CogniPilot/spinali_mcxn_t1_shields/kicad/spinali_mcxn_t1_oflo/spinali_mcxn_t1_oflo.kicad_pcb

## KiCad design kicad/spinali_mcxn_t1_oflo/spinali_mcxn_t1_oflo.kicad_pcb (2026-08-24)

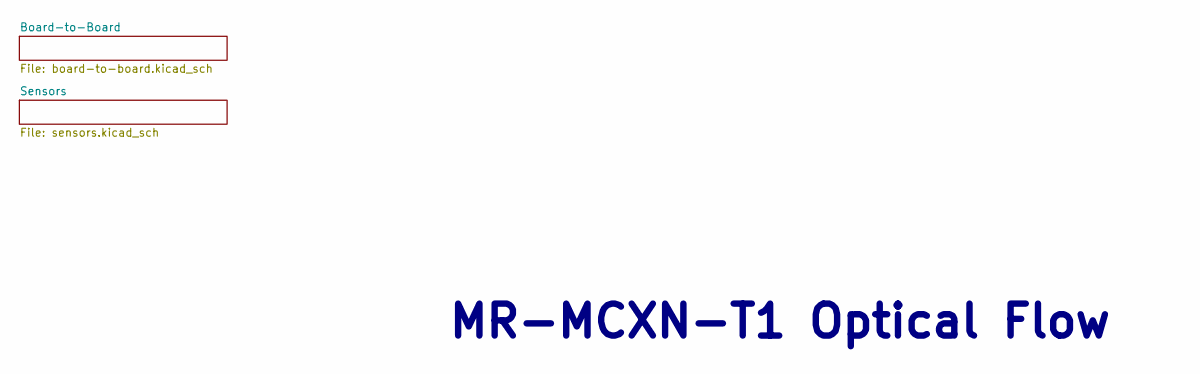
[picture p1: schematic spinali_mcxn_t1_oflo.kicad_sch, ${TITLE}]

Notes on the sheet:
MR-MCXN-T1 Optical Flow

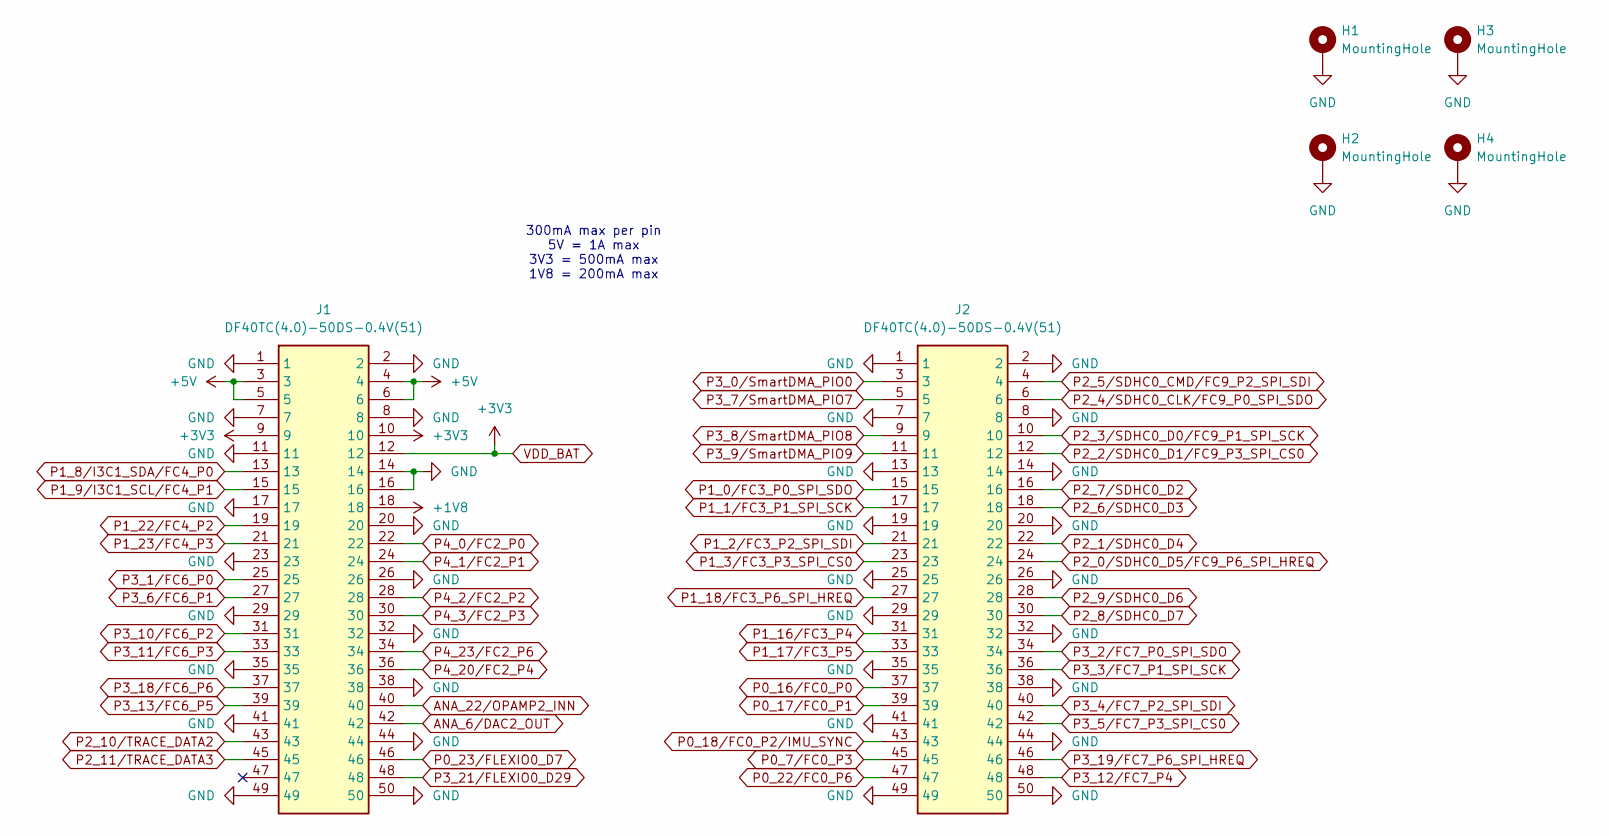
[picture p2: schematic board-to-board.kicad_sch, ${TITLE}]

Parts:
H1, H2, H3, H4: MountingHole; MountingHole_3.2mm_M3_DIN965_Pad
J1, J2: DF40TC(4.0)-50DS-0.4V(51); DigiKey 26-DF40TC(4.0)-50DS-0.4V(51)CT-ND

Connections:
+1V8: J1.18; also elsewhere on the board
+5V: J1.3, J1.4, J1.5, J1.6; also elsewhere on the board
ANA_6/DAC2_OUT: J1.42
ANA_22/OPAMP2_INN: J1.40
GND: H1.1, H2.1, H3.1, H4.1, J1.1, J1.2, J1.7, J1.8, J1.11, J1.14, J1.16, J1.17, J1.20, J1.23, J1.26, J1.29, J1.32, J1.35, J1.38, J1.41, J1.44, J1.49, J1.50, J2.1, J2.2, J2.7, J2.8, J2.13, J2.14, J2.19, J2.20, J2.25, J2.26, J2.29, J2.32, J2.35, J2.38, J2.41, J2.44, J2.49, J2.50; also elsewhere on the board
P0_7/FC0_P3: J2.45
P0_16/FC0_P0: J2.37
P0_17/FC0_P1: J2.39
P0_18/FC0_P2/IMU_SYNC: J2.43; also elsewhere on the board
P0_22/FC0_P6: J2.47
P0_23/FLEXIO0_D7: J1.46
P1_0/FC3_P0_SPI_SDO: J2.15; also elsewhere on the board
P1_1/FC3_P1_SPI_SCK: J2.17; also elsewhere on the board
P1_2/FC3_P2_SPI_SDI: J2.21; also elsewhere on the board
P1_3/FC3_P3_SPI_CS0: J2.23; also elsewhere on the board
P1_8/I3C1_SDA/FC4_P0: J1.13
P1_9/I3C1_SCL/FC4_P1: J1.15
P1_16/FC3_P4: J2.31
P1_17/FC3_P5: J2.33
P1_18/FC3_P6_SPI_HREQ: J2.27; also elsewhere on the board
P1_22/FC4_P2: J1.19
P1_23/FC4_P3: J1.21
P2_0/SDHC0_D5/FC9_P6_SPI_HREQ: J2.24; also elsewhere on the board
P2_1/SDHC0_D4: J2.22
P2_2/SDHC0_D1/FC9_P3_SPI_CS0: J2.12; also elsewhere on the board
P2_3/SDHC0_D0/FC9_P1_SPI_SCK: J2.10; also elsewhere on the board
P2_4/SDHC0_CLK/FC9_P0_SPI_SDO: J2.6; also elsewhere on the board
P2_5/SDHC0_CMD/FC9_P2_SPI_SDI: J2.4; also elsewhere on the board
P2_6/SDHC0_D3: J2.18
P2_7/SDHC0_D2: J2.16
P2_8/SDHC0_D7: J2.30
P2_9/SDHC0_D6: J2.28
P2_10/TRACE_DATA2: J1.43
P2_11/TRACE_DATA3: J1.45
P3_0/SmartDMA_PIO0: J2.3
P3_1/FC6_P0: J1.25; also elsewhere on the board
P3_2/FC7_P0_SPI_SDO: J2.34; also elsewhere on the board
P3_3/FC7_P1_SPI_SCK: J2.36; also elsewhere on the board
P3_4/FC7_P2_SPI_SDI: J2.40; also elsewhere on the board
P3_5/FC7_P3_SPI_CS0: J2.42; also elsewhere on the board
P3_6/FC6_P1: J1.27; also elsewhere on the board
P3_7/SmartDMA_PIO7: J2.5
P3_8/SmartDMA_PIO8: J2.9
P3_9/SmartDMA_PIO9: J2.11
P3_10/FC6_P2: J1.31; also elsewhere on the board
P3_11/FC6_P3: J1.33; also elsewhere on the board
P3_12/FC7_P4: J2.48
P3_13/FC6_P5: J1.39
P3_18/FC6_P6: J1.37; also elsewhere on the board
P3_19/FC7_P6_SPI_HREQ: J2.46; also elsewhere on the board
P3_21/FLEXIO0_D29: J1.48
P4_0/FC2_P0: J1.22
P4_1/FC2_P1: J1.24
P4_2/FC2_P2: J1.28
P4_3/FC2_P3: J1.30
P4_20/FC2_P4: J1.36
P4_23/FC2_P6: J1.34
VDD_BAT: J1.9, J1.10, J1.12; also elsewhere on the board

Notes on the sheet:
300mA max per pin 5V = 1A max 3V3 = 500mA max 1V8 = 200mA max

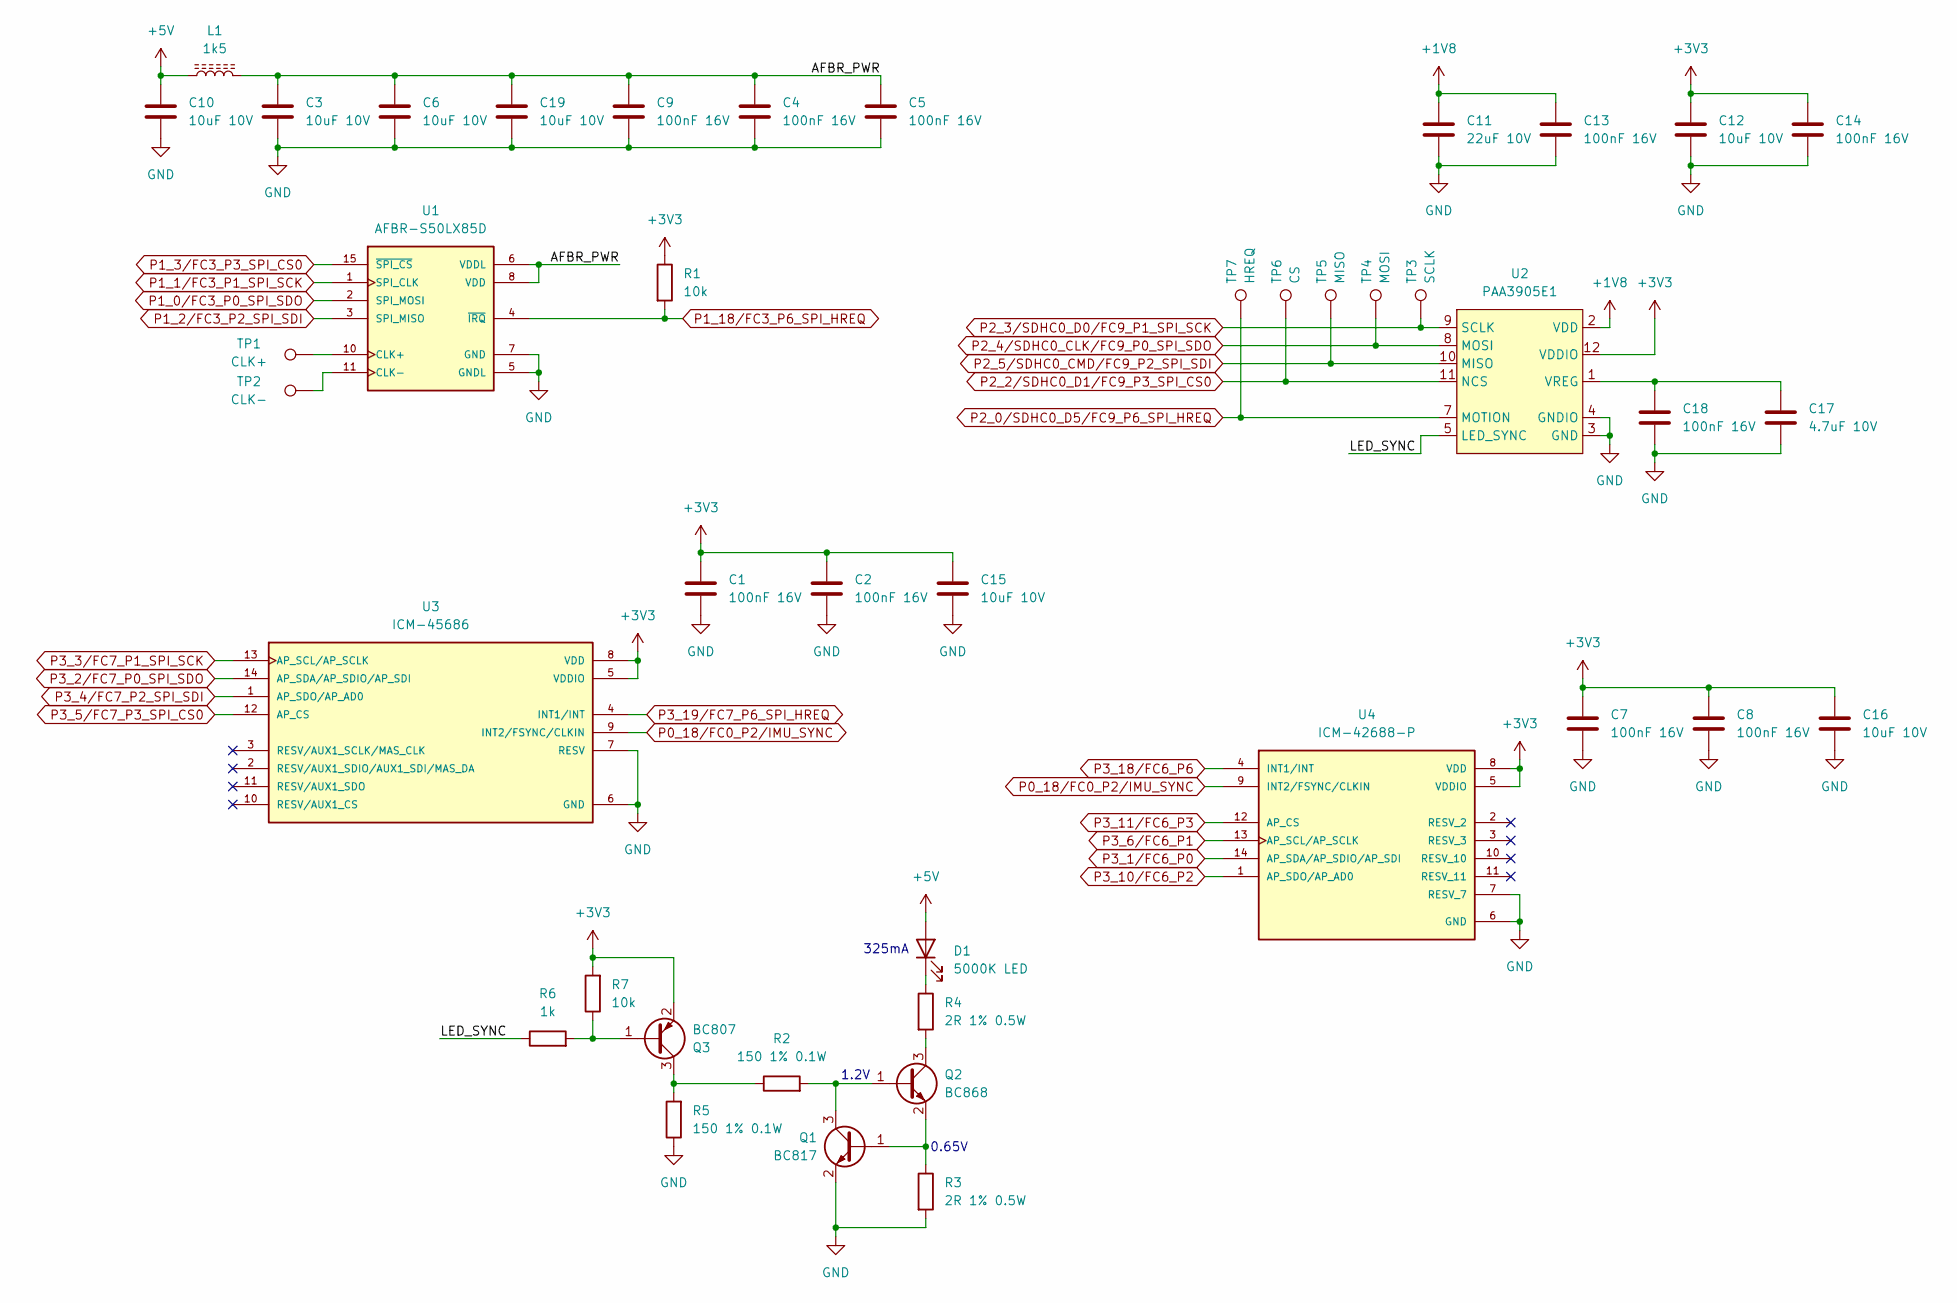
[picture p3: schematic sensors.kicad_sch, ${TITLE}]

Parts:
C1, C2, C4, C5, C7, C8, C9, C13, C14, C18: 100nF 16V; C_0402_1005Metric; JLCPCB C1525
C3, C6, C10, C12, C15, C16, C19: 10uF 10V; C_0805_2012Metric; JLCPCB C86038
C11: 22uF 10V; C_1206_3216Metric; JLCPCB C91604
C17: 4.7uF 10V; C_0603_1608Metric; JLCPCB C389010
D1: 5000K LED; JK3030AWT-P-U50EA; DigiKey 2138-JK3030AWT-P-U50EA0000-N0000001CT-ND
L1: 1k5; L_0603_1608Metric; JLCPCB C82155
Q1: BC817; SOT-23; DigiKey 1727-2919-1-ND
Q2: BC868; SOT-89-3; DigiKey 1727-1568-1-ND
Q3: BC807; SOT-23; DigiKey 1727-2917-1-ND
R1: 10k; R_0402_1005Metric; JLCPCB C144807
R2, R5: 150 1% 0.1W; R_0603_1608Metric; DigiKey 13-AC0603FR-10150RLCT-ND
R3, R4: 2R 1% 0.5W; R_1210_3225Metric; DigiKey 13-RC1210FR-072RLCT-ND
R6: 1k; R_0603_1608Metric; DigiKey 13-AC0603FR-101KLCT-ND
R7: 10k; R_0603_1608Metric; DigiKey 13-AC0603FR-1310KLCT-ND
TP1: CLK+; SolderWirePad_1x01_SMD_1x2mm
TP2: CLK-; SolderWirePad_1x01_SMD_1x2mm
TP3: SCLK; TestPoint_Pad_D1.0mm
TP4: MOSI; TestPoint_Pad_D1.0mm
TP5: MISO; TestPoint_Pad_D1.0mm
TP6: CS; TestPoint_Pad_D1.0mm
TP7: HREQ; TestPoint_Pad_D1.0mm
U1: AFBR-S50LX85D; AFBR-S50xxxxx; DigiKey 516-AFBR-S50LX85D-ND
U2: PAA3905E1; PAA3905E1-Q
U3: ICM-45686; IC_ICM-45686; JLCPCB C22459454
U4: ICM-42688-P; IC_ICM-42688-P; JLCPCB C1850418

Connections:
+1V8: C11.1, C13.1, U2.2 (VDD); also elsewhere on the board
+5V: C10.1, D1.2 (A), L1.1; also elsewhere on the board
/Sensors/LED_SYNC: R6.1, U2.5 (LED_SYNC)
GND: C1.2, C2.2, C3.2, C4.2, C5.2, C6.2, C7.2, C8.2, C9.2, C10.2, C11.2, C12.2, C13.2, C14.2, C15.2, C16.2, C17.2, C18.2, C19.2, Q1.2 (E), R3.2, R5.1, U1.5 (GNDL), U1.7 (GND), U1.9 (GND), U1.14 (GND), U2.3 (GND), U2.4 (GNDIO), U3.6 (GND), U3.7 (RESV), U4.6 (GND), U4.7 (RESV_7); also elsewhere on the board
unnamed: D1.1 (K), R4.1
unnamed: Q1.1 (B), Q2.2 (E), R3.1
unnamed: Q1.3 (C), Q2.1 (B), R2.2
unnamed: Q2.3 (C), R4.2
unnamed: Q3.1 (B), R6.2, R7.1
unnamed: Q3.3 (C), R2.1, R5.2
unnamed: TP1.1, U1.10 (CLK+)
unnamed: TP2.1, U1.11 (CLK-)
unnamed: C17.1, C18.1, U2.1 (VREG)
P0_18/FC0_P2/IMU_SYNC: U3.9 (INT2/FSYNC/CLKIN), U4.9 (INT2/FSYNC/CLKIN); also elsewhere on the board
P1_0/FC3_P0_SPI_SDO: U1.2 (SPI_MOSI); also elsewhere on the board
P1_1/FC3_P1_SPI_SCK: U1.1 (SPI_CLK); also elsewhere on the board
P1_2/FC3_P2_SPI_SDI: U1.3 (SPI_MISO); also elsewhere on the board
P1_3/FC3_P3_SPI_CS0: U1.15 (~SPI_CS); also elsewhere on the board
P1_18/FC3_P6_SPI_HREQ: R1.2, U1.4 (~IRQ); also elsewhere on the board
P2_0/SDHC0_D5/FC9_P6_SPI_HREQ: TP7.1, U2.7 (MOTION); also elsewhere on the board
P2_2/SDHC0_D1/FC9_P3_SPI_CS0: TP6.1, U2.11 (NCS); also elsewhere on the board
P2_3/SDHC0_D0/FC9_P1_SPI_SCK: TP3.1, U2.9 (SCLK); also elsewhere on the board
P2_4/SDHC0_CLK/FC9_P0_SPI_SDO: TP4.1, U2.8 (MOSI); also elsewhere on the board
P2_5/SDHC0_CMD/FC9_P2_SPI_SDI: TP5.1, U2.10 (MISO); also elsewhere on the board
P3_1/FC6_P0: U4.14 (AP_SDA/AP_SDIO/AP_SDI); also elsewhere on the board
P3_2/FC7_P0_SPI_SDO: U3.14 (AP_SDA/AP_SDIO/AP_SDI); also elsewhere on the board
P3_3/FC7_P1_SPI_SCK: U3.13 (AP_SCL/AP_SCLK); also elsewhere on the board
P3_4/FC7_P2_SPI_SDI: U3.1 (AP_SDO/AP_AD0); also elsewhere on the board
P3_5/FC7_P3_SPI_CS0: U3.12 (AP_CS); also elsewhere on the board
P3_6/FC6_P1: U4.13 (AP_SCL/AP_SCLK); also elsewhere on the board
P3_10/FC6_P2: U4.1 (AP_SDO/AP_AD0); also elsewhere on the board
P3_11/FC6_P3: U4.12 (AP_CS); also elsewhere on the board
P3_18/FC6_P6: U4.4 (INT1/INT); also elsewhere on the board
P3_19/FC7_P6_SPI_HREQ: U3.4 (INT1/INT); also elsewhere on the board
VDD: C3.1, C4.1, C5.1, C6.1, C9.1, C19.1, L1.2, U1.6 (VDDL), U1.8 (VDD), U1.13 (VDD)
VDD_BAT: C1.1, C2.1, C7.1, C8.1, C12.1, C14.1, C15.1, C16.1, Q3.2 (E), R1.1, R7.2, U2.12 (VDDIO), U3.5 (VDDIO), U3.8 (VDD), U4.5 (VDDIO), U4.8 (VDD); also elsewhere on the board

Notes on the sheet:
325mA
0.65V
1.2V

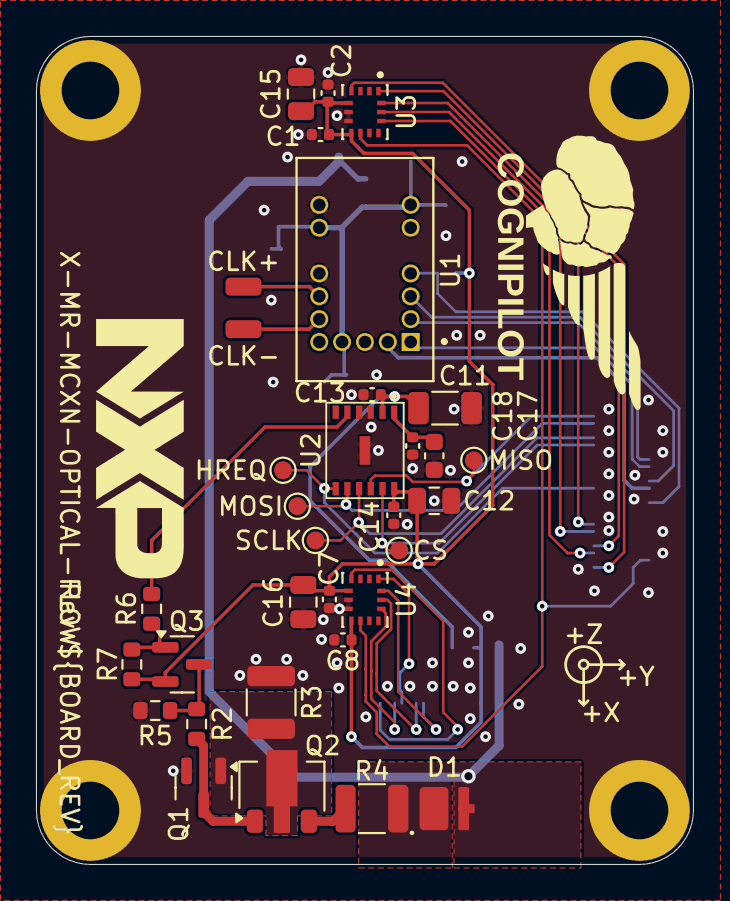
[picture p4: board spinali_mcxn_t1_oflo.kicad_pcb from above]

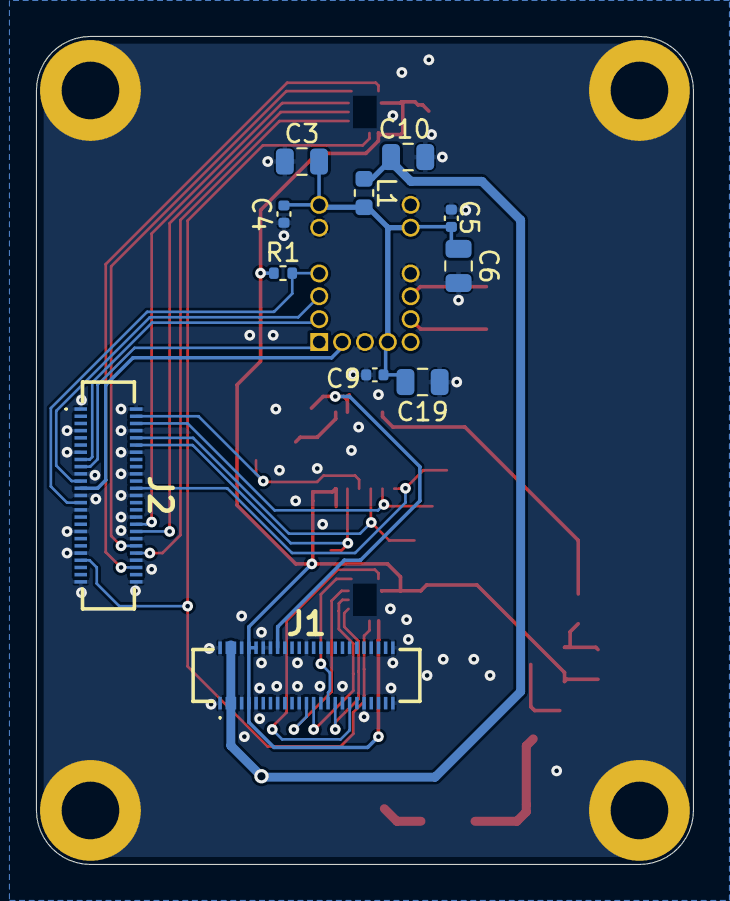
[picture p5: board spinali_mcxn_t1_oflo.kicad_pcb from below]

Board: 4 copper layers, 36.5 x 46.0 mm, 48 parts (11 on the bottom side), 36 nets.
