CogniPilot/spinali_mcxn_t1_shields/kicad/spinali_mcxn_t1_io/spinali_mcxn_t1_io.kicad_pcb

## KiCad design kicad/spinali_mcxn_t1_io/spinali_mcxn_t1_io.kicad_pcb (2026-08-24)

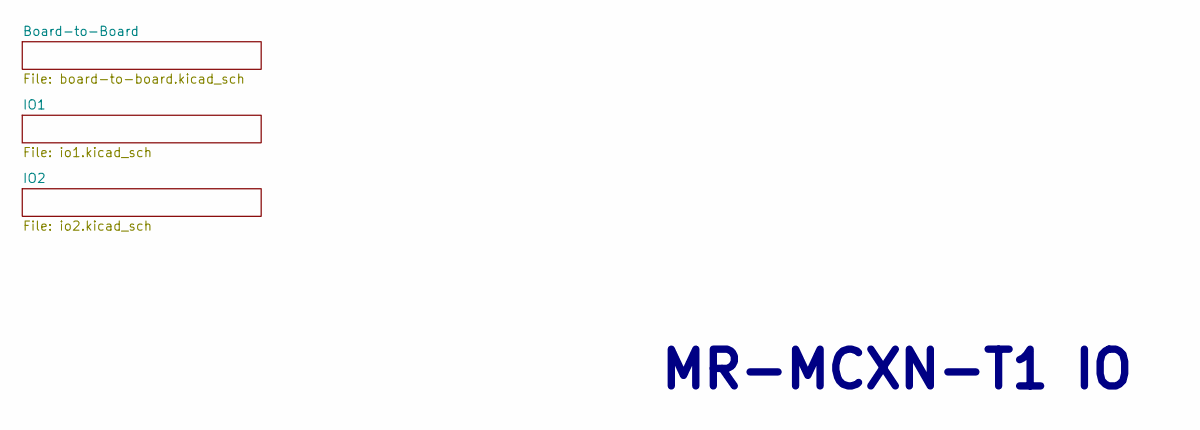
[picture p6: schematic spinali_mcxn_t1_io.kicad_sch, ${TITLE}]

Notes on the sheet:
MR-MCXN-T1 IO

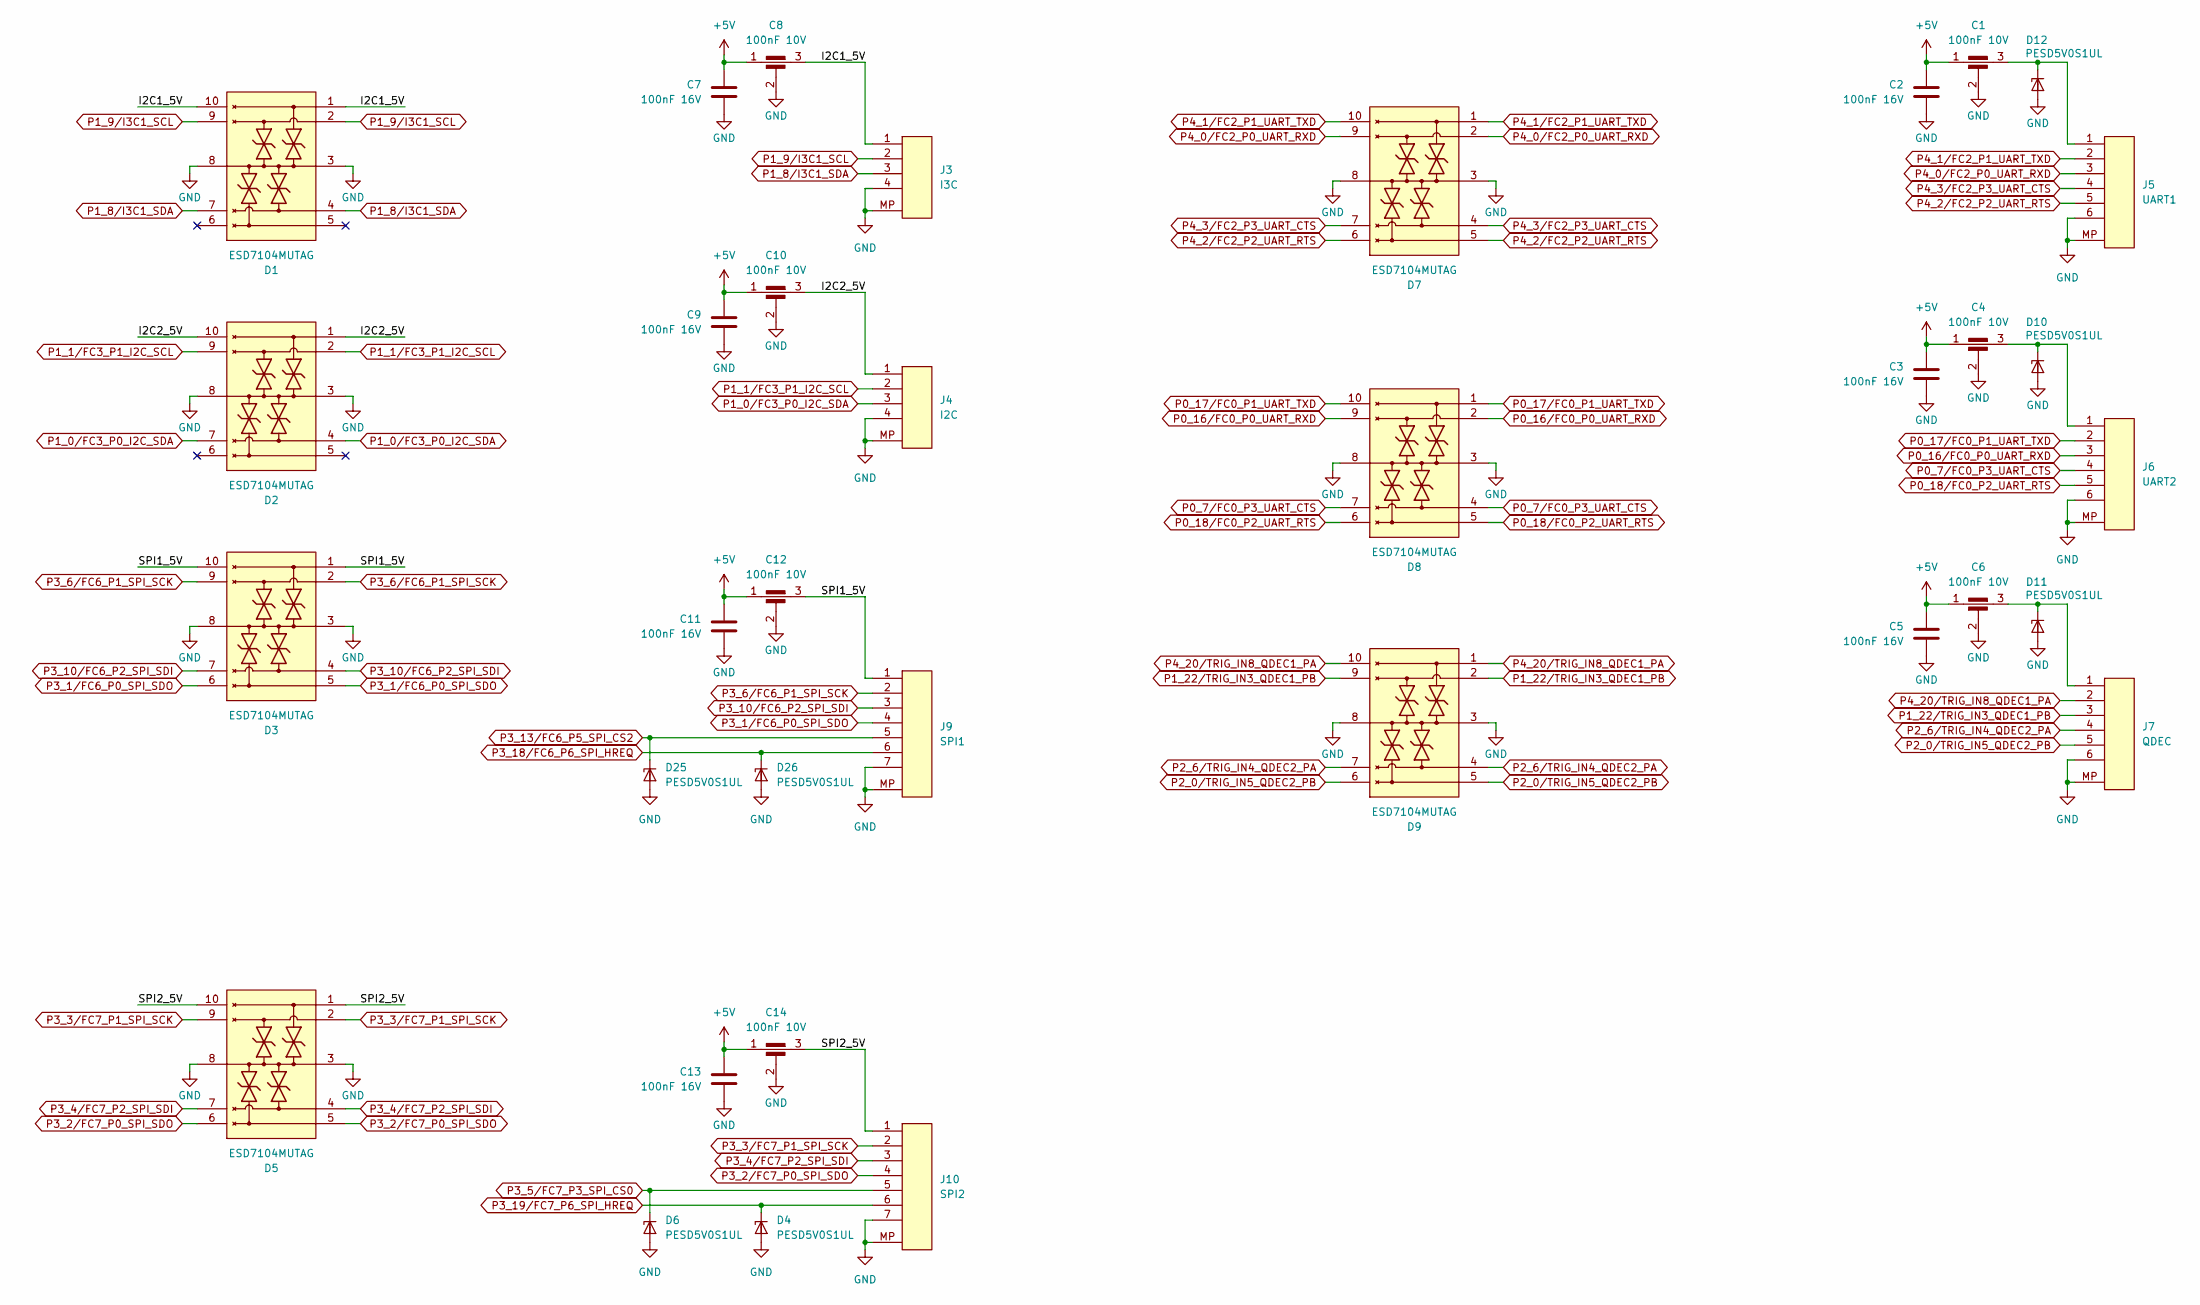
[picture p7: schematic io1.kicad_sch, ${TITLE}]

Parts:
C1, C4, C6, C8, C10, C12, C14: 100nF 10V; FIL_NFM15PC104R1A3D; DigiKey 490-17918-1-ND
C2, C3, C5, C7, C9, C11, C13: 100nF 16V; C_0402_1005Metric; DigiKey 490-6328-1-ND
D1, D2, D3, D5, D7, D8, D9: ESD7104MUTAG; ESD8104MUTAG; DigiKey ESD7104MUTAGOSCT-ND
D4, D6, D10, D11, D12, D25, D26: PESD5V0S1UL; PESD5V0S1ULD315; DigiKey 1727-4189-1-ND
J3: I3C; JST_GH_BM04B-GHS-TBT_1x04-1MP_P1.25mm_Vertical; DigiKey 455-BM04B-GHS-TBTCT-ND
J4: I2C; JST_GH_BM04B-GHS-TBT_1x04-1MP_P1.25mm_Vertical; DigiKey 455-BM04B-GHS-TBTCT-ND
J5: UART1; JST_GH_BM06B-GHS-TBT_1x06-1MP_P1.25mm_Vertical; DigiKey 455-BM06B-GHS-TBTCT-ND
J6: UART2; JST_GH_BM06B-GHS-TBT_1x06-1MP_P1.25mm_Vertical; DigiKey 455-BM06B-GHS-TBTCT-ND
J7: QDEC; JST_GH_BM06B-GHS-TBT_1x06-1MP_P1.25mm_Vertical; DigiKey 455-BM06B-GHS-TBTCT-ND
J9: SPI1; JST_GH_BM07B-GHS-TBT_1x07-1MP_P1.25mm_Vertical; DigiKey 455-BM07B-GHS-TBTCT-ND
J10: SPI2; JST_GH_BM07B-GHS-TBT_1x07-1MP_P1.25mm_Vertical; DigiKey 455-BM07B-GHS-TBTCT-ND

Connections:
+5V: C1.1, C2.1, C3.1, C4.1, C5.1, C6.1, C7.1, C8.1, C9.1, C10.1, C11.1, C12.1, C13.1, C14.1; also elsewhere on the board
/IO1/I2C1_5V: C8.3, D1.1 (IO_1), D1.10 (NC_4), J3.1
/IO1/I2C2_5V: C10.3, D2.1 (IO_1), D2.10 (NC_4), J4.1
/IO1/SPI1_5V: C12.3, D3.1 (IO_1), D3.10 (NC_4), J9.1
/IO1/SPI2_5V: C14.3, D5.1 (IO_1), D5.10 (NC_4), J10.1
GND: C1.2, C1.4 (2), C2.2, C3.2, C4.2, C4.4 (2), C5.2, C6.2, C6.4 (2), C7.2, C8.2, C8.4 (2), C9.2, C10.2, C10.4 (2), C11.2, C12.2, C12.4 (2), C13.2, C14.2, C14.4 (2), D1.3 (GND_1), D1.8 (GND_2), D2.3 (GND_1), D2.8 (GND_2), D3.3 (GND_1), D3.8 (GND_2), D4.2 (A), D5.3 (GND_1), D5.8 (GND_2), D6.2 (A), D7.3 (GND_1), D7.8 (GND_2), D8.3 (GND_1), D8.8 (GND_2), D9.3 (GND_1), D9.8 (GND_2), D10.2 (A), D11.2 (A), D12.2 (A), D25.2 (A), D26.2 (A), J3.4 (1), J3.MP, J4.4 (1), J4.MP, J5.6 (1), J5.MP, J6.6 (1), J6.MP, J7.6 (1), J7.MP, J9.7 (1), J9.MP, J10.7 (1), J10.MP; also elsewhere on the board
unnamed: C4.3, D10.1 (K1), J6.1
unnamed: C6.3, D11.1 (K1), J7.1
unnamed: C1.3, D12.1 (K1), J5.1
P0_7/FC0_P3_UART_CTS: D8.4 (IO_3), D8.7 (NC_2), J6.4 (1); also elsewhere on the board
P0_16/FC0_P0_UART_RXD: D8.2 (IO_2), D8.9 (NC_3), J6.3 (1); also elsewhere on the board
P0_17/FC0_P1_UART_TXD: D8.1 (IO_1), D8.10 (NC_4), J6.2 (1); also elsewhere on the board
P0_18/FC0_P2_UART_RTS: D8.5 (IO_4), D8.6 (NC_1), J6.5 (1); also elsewhere on the board
P1_0/FC3_P0_I2C_SDA: D2.4 (IO_3), D2.7 (NC_2), J4.3 (1); also elsewhere on the board
P1_1/FC3_P1_I2C_SCL: D2.2 (IO_2), D2.9 (NC_3), J4.2 (1); also elsewhere on the board
P1_8/I3C1_SDA: D1.4 (IO_3), D1.7 (NC_2), J3.3 (1); also elsewhere on the board
P1_9/I3C1_SCL: D1.2 (IO_2), D1.9 (NC_3), J3.2 (1); also elsewhere on the board
P1_22/TRIG_IN3_QDEC1_PB: D9.2 (IO_2), D9.9 (NC_3), J7.3 (1); also elsewhere on the board
P2_0/TRIG_IN5_QDEC2_PB: D9.5 (IO_4), D9.6 (NC_1), J7.5 (1); also elsewhere on the board
P2_6/TRIG_IN4_QDEC2_PA: D9.4 (IO_3), D9.7 (NC_2), J7.4 (1); also elsewhere on the board
P3_1/FC6_P0_SPI_SDO: D3.5 (IO_4), D3.6 (NC_1), J9.4 (1); also elsewhere on the board
P3_2/FC7_P0_SPI_SDO: D5.5 (IO_4), D5.6 (NC_1), J10.4 (1); also elsewhere on the board
P3_3/FC7_P1_SPI_SCK: D5.2 (IO_2), D5.9 (NC_3), J10.2 (1); also elsewhere on the board
P3_4/FC7_P2_SPI_SDI: D5.4 (IO_3), D5.7 (NC_2), J10.3 (1); also elsewhere on the board
P3_5/FC7_P3_SPI_CS0: D6.1 (K1), J10.5 (1); also elsewhere on the board
P3_6/FC6_P1_SPI_SCK: D3.2 (IO_2), D3.9 (NC_3), J9.2 (1); also elsewhere on the board
P3_10/FC6_P2_SPI_SDI: D3.4 (IO_3), D3.7 (NC_2), J9.3 (1); also elsewhere on the board
P3_13/FC6_P5_SPI_CS2: D25.1 (K1), J9.5 (1); also elsewhere on the board
P3_18/FC6_P6_SPI_HREQ: D26.1 (K1), J9.6 (1); also elsewhere on the board
P3_19/FC7_P6_SPI_HREQ: D4.1 (K1), J10.6 (1); also elsewhere on the board
P4_0/FC2_P0_UART_RXD: D7.2 (IO_2), D7.9 (NC_3), J5.3 (1); also elsewhere on the board
P4_1/FC2_P1_UART_TXD: D7.1 (IO_1), D7.10 (NC_4), J5.2 (1); also elsewhere on the board
P4_2/FC2_P2_UART_RTS: D7.5 (IO_4), D7.6 (NC_1), J5.5 (1); also elsewhere on the board
P4_3/FC2_P3_UART_CTS: D7.4 (IO_3), D7.7 (NC_2), J5.4 (1); also elsewhere on the board
P4_20/TRIG_IN8_QDEC1_PA: D9.1 (IO_1), D9.10 (NC_4), J7.2 (1); also elsewhere on the board

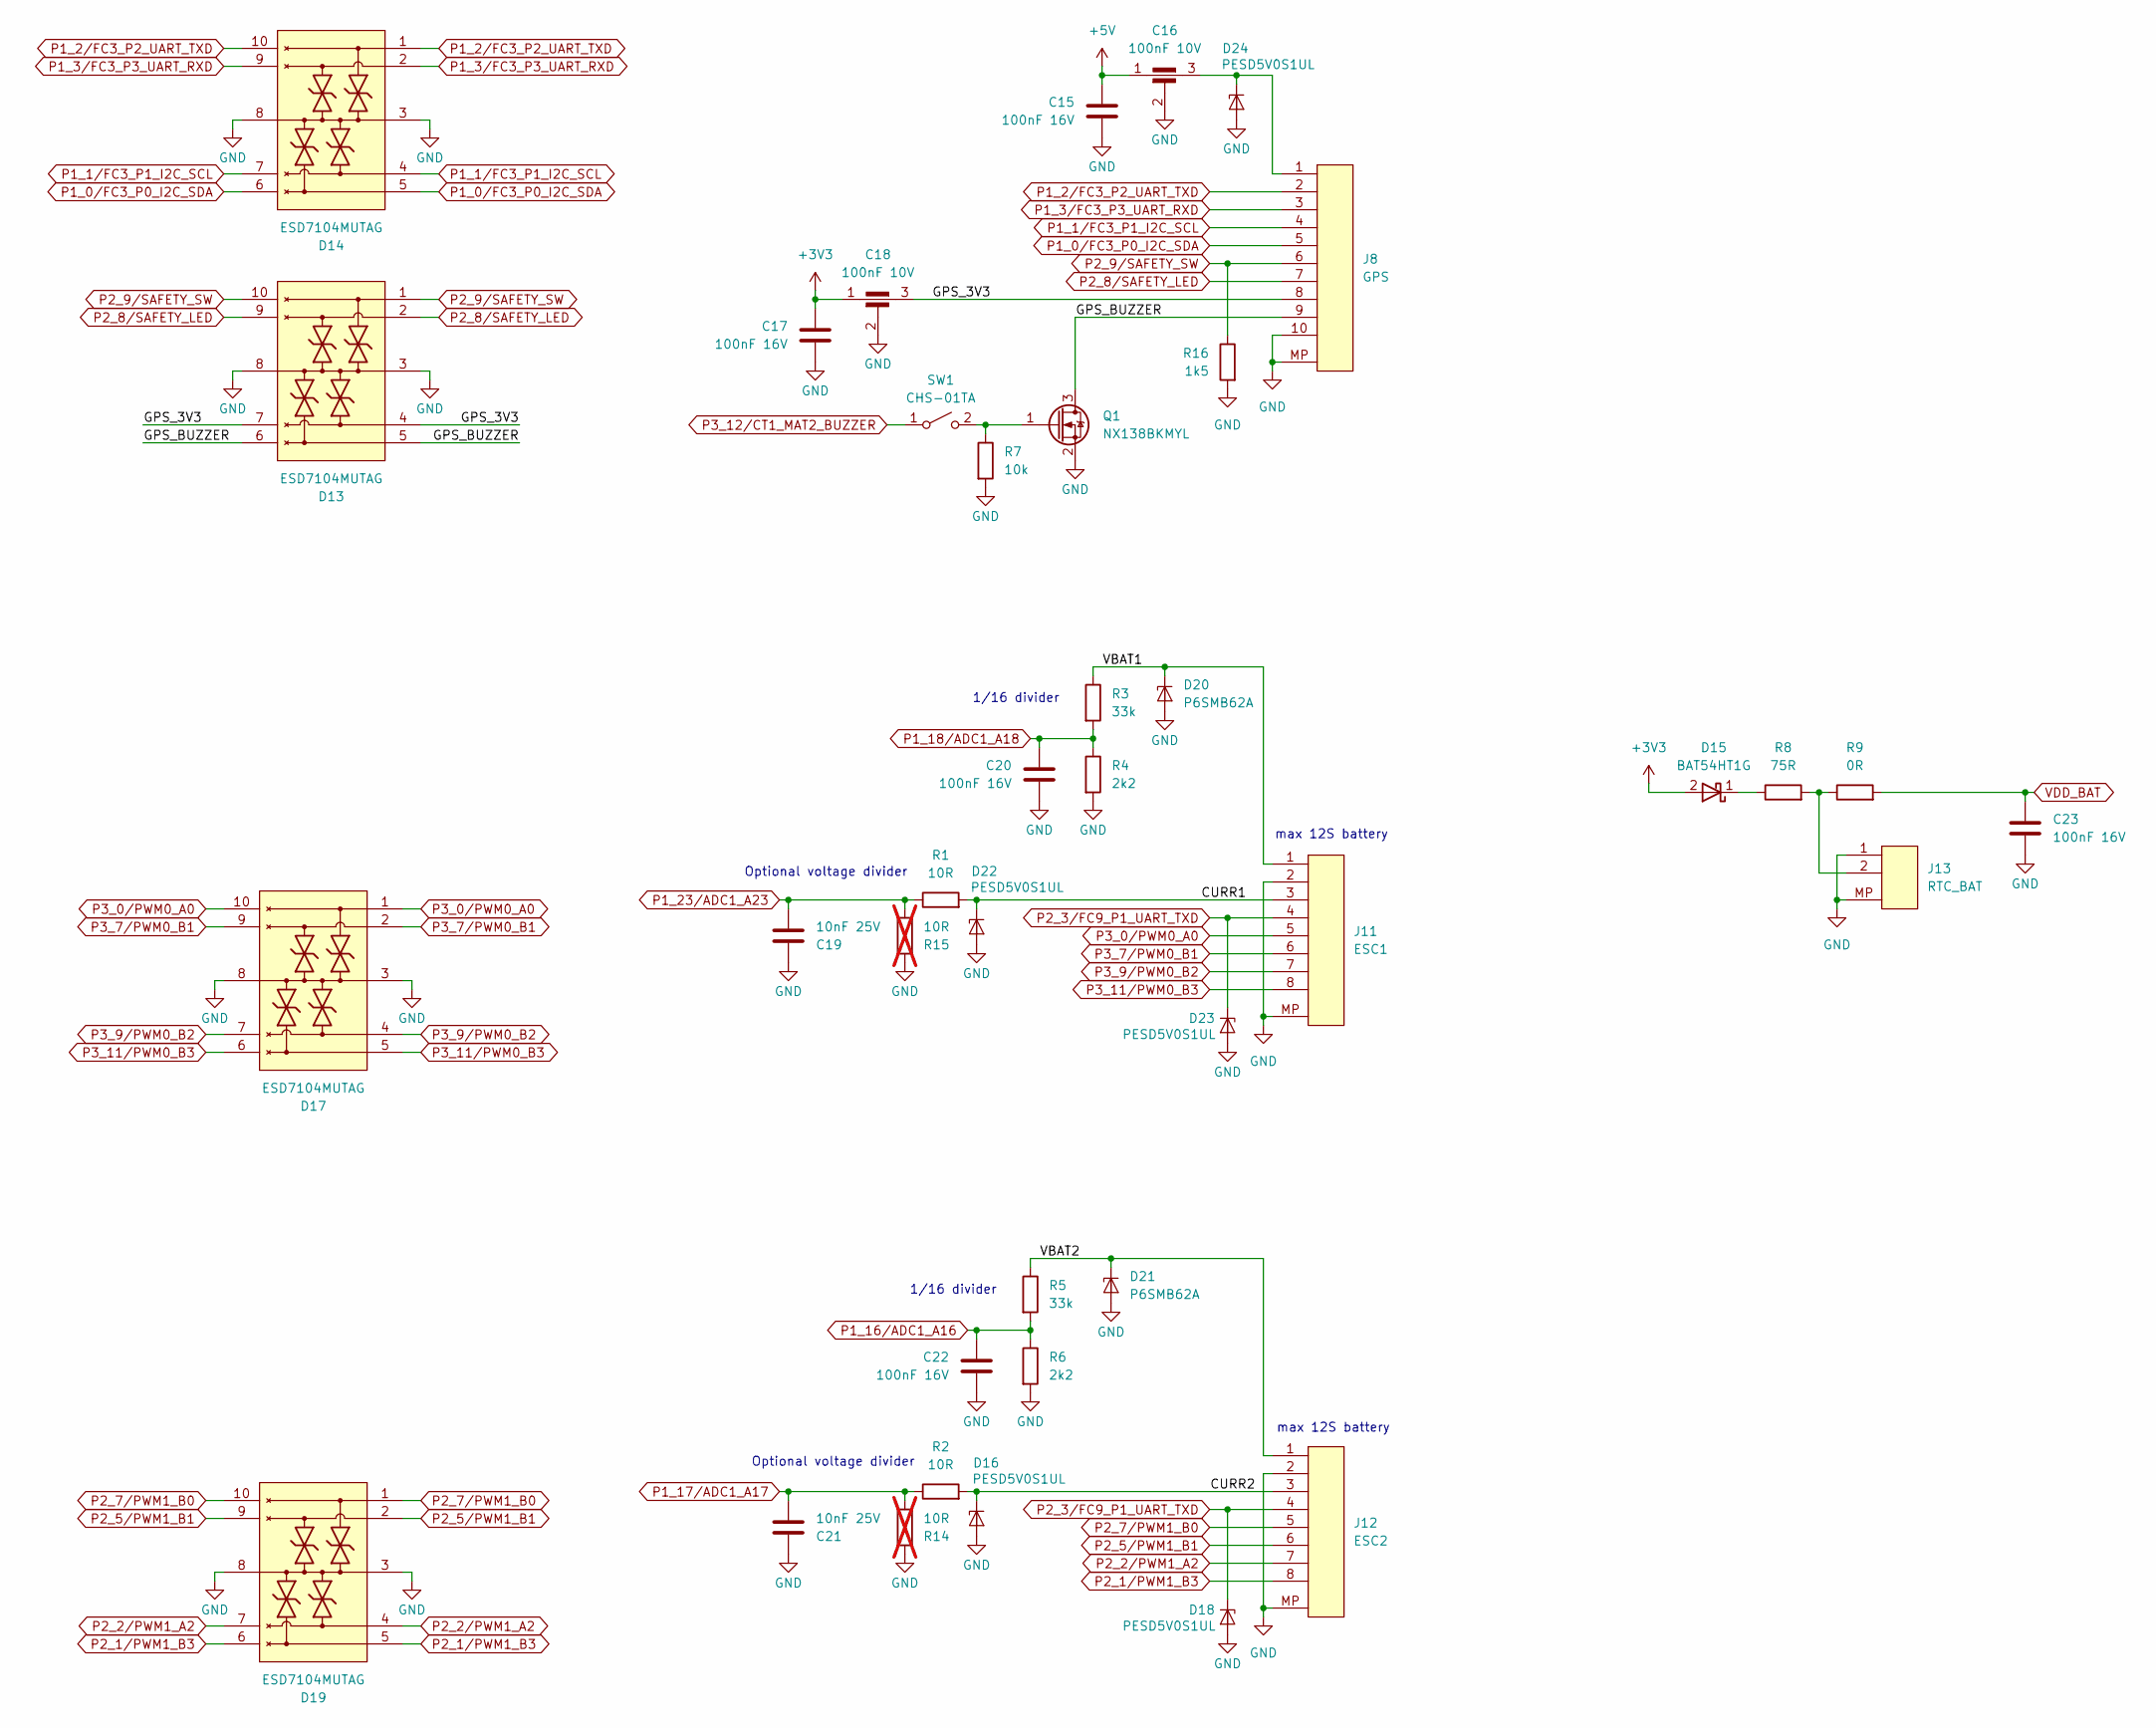
[picture p8: schematic io2.kicad_sch, ${TITLE}]

Parts:
C15, C17, C20, C22, C23: 100nF 16V; C_0402_1005Metric; DigiKey 490-6328-1-ND
C16, C18: 100nF 10V; FIL_NFM15PC104R1A3D; DigiKey 490-17918-1-ND
C19, C21: 10nF 25V; C_0402_1005Metric; DigiKey 490-GRM1555C1E103JE01DCT-ND
D13, D14, D17, D19: ESD7104MUTAG; ESD8104MUTAG; DigiKey ESD7104MUTAGOSCT-ND
D15: BAT54HT1G; D_SOD-323; DigiKey BAT54HT1GOSCT-ND
D16, D18, D22, D23, D24: PESD5V0S1UL; PESD5V0S1ULD315; DigiKey 1727-4189-1-ND
D20, D21: P6SMB62A; SOD1002-1; DigiKey P6SMB62ALFCT-ND
J8: GPS; JST_GH_BM10B-GHS-TBT_1x10-1MP_P1.25mm_Vertical; DigiKey 455-BM10B-GHS-TBTCT-ND
J11: ESC1; JST_SH_SM08B-SRSS-TB_1x08-1MP_P1.00mm_Horizontal; DigiKey 455-1808-1-ND
J12: ESC2; JST_SH_SM08B-SRSS-TB_1x08-1MP_P1.00mm_Horizontal; DigiKey 455-1808-1-ND
J13: RTC_BAT; JST_SH_SM02B-SRSS-TB_1x02-1MP_P1.00mm_Horizontal; DigiKey 455-SM02B-SRSS-TBCT-ND
Q1: NX138BKMYL; DFN985X585X50-3N; DigiKey 1727-NX138BKMYLCT-ND
R1, R2: 10R; R_0402_1005Metric; DigiKey YAG3438CT-ND
R3, R5: 33k; R_0402_1005Metric; DigiKey 311-33.0KLRCT-ND
R4, R6: 2k2; R_0402_1005Metric; DigiKey YAG3467CT-ND
R7: 10k; R_0402_1005Metric; DigiKey 311-10.0KLRCT-ND
R8: 75R; R_0402_1005Metric; DigiKey 13-RC0402FR-1375RLCT-ND
R9: 0R; R_0402_1005Metric; DigiKey 311-0.0JRCT-ND
R14, R15: 10R; R_0402_1005Metric; DigiKey YAG3438CT-ND; not fitted
R16: 1k5; R_0402_1005Metric; DigiKey 311-1.50KLRCT-ND
SW1: CHS-01TA; DigiKey 563-1003-1-ND

Connections:
+3V3: C17.1, C18.1, D15.2 (A); also elsewhere on the board
+5V: C15.1, C16.1; also elsewhere on the board
/IO2/CURR1: D22.1 (K1), J11.3 (1), R1.2
/IO2/CURR2: D16.1 (K1), J12.3 (1), R2.2
/IO2/GPS_3V3: C18.3, D13.4 (IO_3), D13.7 (NC_2), J8.8 (1)
/IO2/GPS_BUZZER: D13.5 (IO_4), D13.6 (NC_1), J8.9 (1), Q1.3 (D)
/IO2/VBAT1: D20.1 (K1), J11.1, R3.1
/IO2/VBAT2: D21.1 (K1), J12.1, R5.1
GND: C15.2, C16.2, C16.4 (2), C17.2, C18.2, C18.4 (2), C19.1, C20.2, C21.1, C22.2, C23.2, D13.3 (GND_1), D13.8 (GND_2), D14.3 (GND_1), D14.8 (GND_2), D16.2 (A), D17.3 (GND_1), D17.8 (GND_2), D18.2 (A), D19.3 (GND_1), D19.8 (GND_2), D20.2 (A), D21.2 (A), D22.2 (A), D23.2 (A), D24.2 (A), J8.10 (1), J8.MP, J11.2 (1), J11.MP, J12.2 (1), J12.MP, J13.1, J13.MP, Q1.2 (S), R4.2, R6.2, R7.2, R14.2, R15.2, R16.2; also elsewhere on the board
unnamed: D15.1 (K), R8.1
unnamed: C16.3, D24.1 (K1), J8.1
unnamed: J13.2 (1), R8.2, R9.1
unnamed: Q1.1 (G), R7.1, SW1.2 (B)
P1_0/FC3_P0_I2C_SDA: D14.5 (IO_4), D14.6 (NC_1), J8.5 (1); also elsewhere on the board
P1_1/FC3_P1_I2C_SCL: D14.4 (IO_3), D14.7 (NC_2), J8.4 (1); also elsewhere on the board
P1_2/FC3_P2_UART_TXD: D14.1 (IO_1), D14.10 (NC_4), J8.2 (1); also elsewhere on the board
P1_3/FC3_P3_UART_RXD: D14.2 (IO_2), D14.9 (NC_3), J8.3 (1); also elsewhere on the board
P1_16/ADC1_A16: C22.1, R5.2, R6.1; also elsewhere on the board
P1_17/ADC1_A17: C21.2, R2.1, R14.1; also elsewhere on the board
P1_18/ADC1_A18: C20.1, R3.2, R4.1; also elsewhere on the board
P1_23/ADC1_A23: C19.2, R1.1, R15.1; also elsewhere on the board
P2_1/PWM1_B3: D19.5 (IO_4), D19.6 (NC_1), J12.8 (1); also elsewhere on the board
P2_2/PWM1_A2: D19.4 (IO_3), D19.7 (NC_2), J12.7 (1); also elsewhere on the board
P2_3/FC9_P1_UART_TXD: D18.1 (K1), D23.1 (K1), J11.4 (1), J12.4 (1); also elsewhere on the board
P2_5/PWM1_B1: D19.2 (IO_2), D19.9 (NC_3), J12.6 (1); also elsewhere on the board
P2_7/PWM1_B0: D19.1 (IO_1), D19.10 (NC_4), J12.5 (1); also elsewhere on the board
P2_8/SAFETY_LED: D13.2 (IO_2), D13.9 (NC_3), J8.7 (1); also elsewhere on the board
P2_9/SAFETY_SW: D13.1 (IO_1), D13.10 (NC_4), J8.6 (1), R16.1; also elsewhere on the board
P3_0/PWM0_A0: D17.1 (IO_1), D17.10 (NC_4), J11.5 (1); also elsewhere on the board
P3_7/PWM0_B1: D17.2 (IO_2), D17.9 (NC_3), J11.6 (1); also elsewhere on the board
P3_9/PWM0_B2: D17.4 (IO_3), D17.7 (NC_2), J11.7 (1); also elsewhere on the board
P3_11/PWM0_B3: D17.5 (IO_4), D17.6 (NC_1), J11.8 (1); also elsewhere on the board
P3_12/CT1_MAT2_BUZZER: SW1.1 (A); also elsewhere on the board
VDD_BAT: C23.1, R9.2; also elsewhere on the board

Notes on the sheet:
1/16 divider
Optional voltage divider
max 12S battery
