CogniPilot/spinali_mcxn_t1_shields/kicad/spinali_mcxn_t1_io/spinali_mcxn_t1_io.kicad_pcb

## KiCad design kicad/spinali_mcxn_t1_io/spinali_mcxn_t1_io.kicad_pcb (continued)

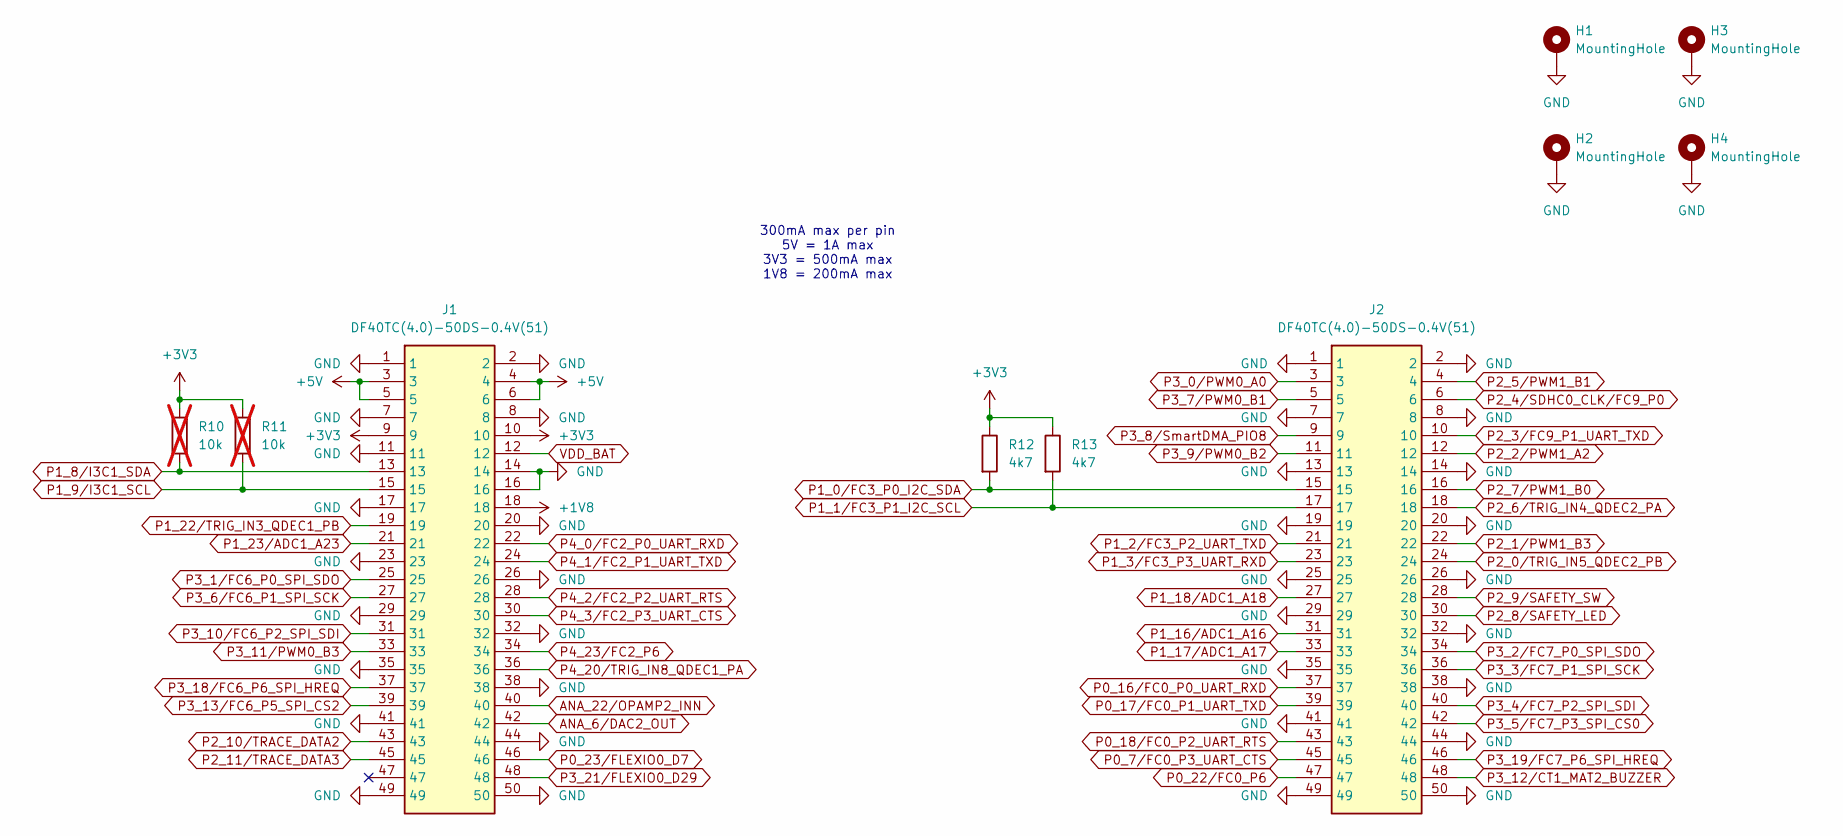
[picture p9: schematic board-to-board.kicad_sch, ${TITLE}]

Parts:
H1, H2, H3, H4: MountingHole; MountingHole_3.2mm_M3_DIN965_Pad
J1, J2: DF40TC(4.0)-50DS-0.4V(51); DigiKey 26-DF40TC(4.0)-50DS-0.4V(51)CT-ND
R10, R11: 10k; R_0603_1608Metric; DigiKey 311-10.0KHRCT-ND; not fitted
R12, R13: 4k7; R_0603_1608Metric; DigiKey 311-4.70KHRCT-ND

Connections:
+1V8: J1.18
+3V3: J1.9, J1.10, R10.1, R11.1, R12.1, R13.1; also elsewhere on the board
+5V: J1.3, J1.4, J1.5, J1.6; also elsewhere on the board
ANA_6/DAC2_OUT: J1.42
ANA_22/OPAMP2_INN: J1.40
GND: H1.1, H2.1, H3.1, H4.1, J1.1, J1.2, J1.7, J1.8, J1.11, J1.14, J1.16, J1.17, J1.20, J1.23, J1.26, J1.29, J1.32, J1.35, J1.38, J1.41, J1.44, J1.49, J1.50, J2.1, J2.2, J2.7, J2.8, J2.13, J2.14, J2.19, J2.20, J2.25, J2.26, J2.29, J2.32, J2.35, J2.38, J2.41, J2.44, J2.49, J2.50; also elsewhere on the board
P0_7/FC0_P3_UART_CTS: J2.45; also elsewhere on the board
P0_16/FC0_P0_UART_RXD: J2.37; also elsewhere on the board
P0_17/FC0_P1_UART_TXD: J2.39; also elsewhere on the board
P0_18/FC0_P2_UART_RTS: J2.43; also elsewhere on the board
P0_22/FC0_P6: J2.47
P0_23/FLEXIO0_D7: J1.46
P1_0/FC3_P0_I2C_SDA: J2.15, R12.2; also elsewhere on the board
P1_1/FC3_P1_I2C_SCL: J2.17, R13.2; also elsewhere on the board
P1_2/FC3_P2_UART_TXD: J2.21; also elsewhere on the board
P1_3/FC3_P3_UART_RXD: J2.23; also elsewhere on the board
P1_8/I3C1_SDA: J1.13, R10.2; also elsewhere on the board
P1_9/I3C1_SCL: J1.15, R11.2; also elsewhere on the board
P1_16/ADC1_A16: J2.31; also elsewhere on the board
P1_17/ADC1_A17: J2.33; also elsewhere on the board
P1_18/ADC1_A18: J2.27; also elsewhere on the board
P1_22/TRIG_IN3_QDEC1_PB: J1.19; also elsewhere on the board
P1_23/ADC1_A23: J1.21; also elsewhere on the board
P2_0/TRIG_IN5_QDEC2_PB: J2.24; also elsewhere on the board
P2_1/PWM1_B3: J2.22; also elsewhere on the board
P2_2/PWM1_A2: J2.12; also elsewhere on the board
P2_3/FC9_P1_UART_TXD: J2.10; also elsewhere on the board
P2_4/SDHC0_CLK/FC9_P0: J2.6
P2_5/PWM1_B1: J2.4; also elsewhere on the board
P2_6/TRIG_IN4_QDEC2_PA: J2.18; also elsewhere on the board
P2_7/PWM1_B0: J2.16; also elsewhere on the board
P2_8/SAFETY_LED: J2.30; also elsewhere on the board
P2_9/SAFETY_SW: J2.28; also elsewhere on the board
P2_10/TRACE_DATA2: J1.43
P2_11/TRACE_DATA3: J1.45
P3_0/PWM0_A0: J2.3; also elsewhere on the board
P3_1/FC6_P0_SPI_SDO: J1.25; also elsewhere on the board
P3_2/FC7_P0_SPI_SDO: J2.34; also elsewhere on the board
P3_3/FC7_P1_SPI_SCK: J2.36; also elsewhere on the board
P3_4/FC7_P2_SPI_SDI: J2.40; also elsewhere on the board
P3_5/FC7_P3_SPI_CS0: J2.42; also elsewhere on the board
P3_6/FC6_P1_SPI_SCK: J1.27; also elsewhere on the board
P3_7/PWM0_B1: J2.5; also elsewhere on the board
P3_8/SmartDMA_PIO8: J2.9
P3_9/PWM0_B2: J2.11; also elsewhere on the board
P3_10/FC6_P2_SPI_SDI: J1.31; also elsewhere on the board
P3_11/PWM0_B3: J1.33; also elsewhere on the board
P3_12/CT1_MAT2_BUZZER: J2.48; also elsewhere on the board
P3_13/FC6_P5_SPI_CS2: J1.39; also elsewhere on the board
P3_18/FC6_P6_SPI_HREQ: J1.37; also elsewhere on the board
P3_19/FC7_P6_SPI_HREQ: J2.46; also elsewhere on the board
P3_21/FLEXIO0_D29: J1.48
P4_0/FC2_P0_UART_RXD: J1.22; also elsewhere on the board
P4_1/FC2_P1_UART_TXD: J1.24; also elsewhere on the board
P4_2/FC2_P2_UART_RTS: J1.28; also elsewhere on the board
P4_3/FC2_P3_UART_CTS: J1.30; also elsewhere on the board
P4_20/TRIG_IN8_QDEC1_PA: J1.36; also elsewhere on the board
P4_23/FC2_P6: J1.34
VDD_BAT: J1.12; also elsewhere on the board

Notes on the sheet:
300mA max per pin 5V = 1A max 3V3 = 500mA max 1V8 = 200mA max

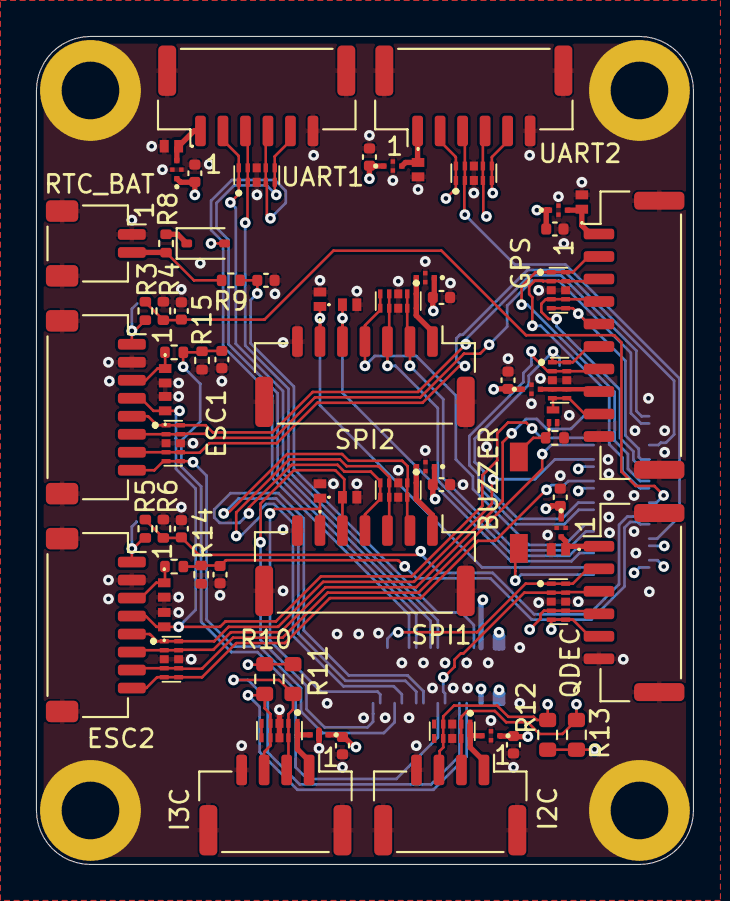
[picture p10: board spinali_mcxn_t1_io.kicad_pcb from above]

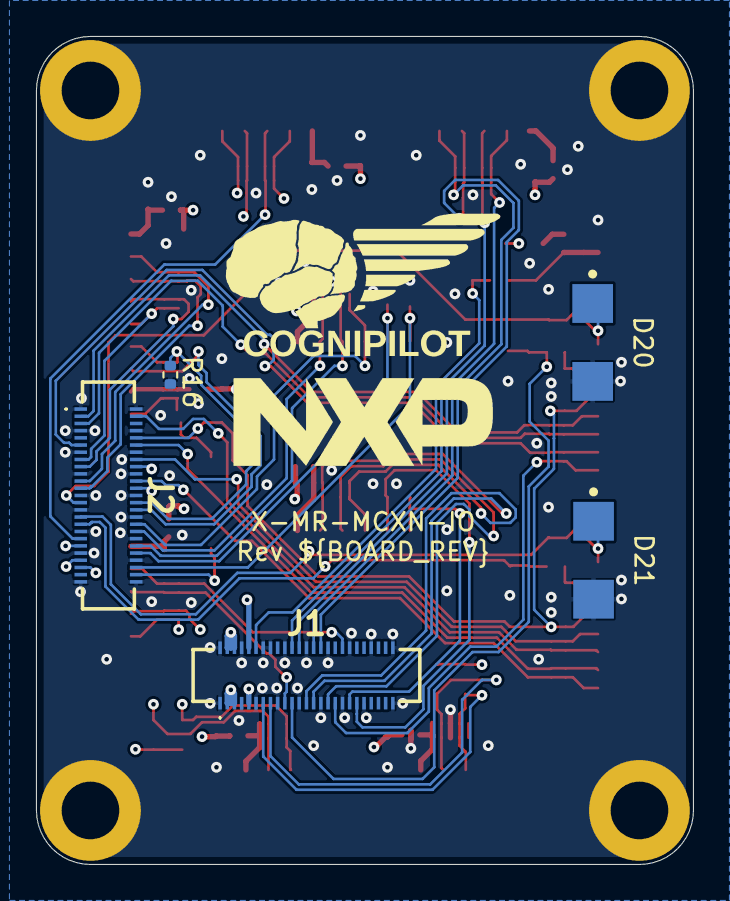
[picture p11: board spinali_mcxn_t1_io.kicad_pcb from below]

Board: 4 copper layers, 36.5 x 46.0 mm, 84 parts (5 on the bottom side), 65 nets.
